arussoItaly/DCF77-arduino-nano/(commit log)

2026-10-26 Update README with resistance specifications for LED
    Added resistance value details for optional components.
2026-10-26 Revise wiring diagram and component details
    Updated the wiring diagram and clarified component descriptions in the README.
2026-10-26 Fix formatting in README for Arduino Nano connection
2026-10-26 Update README with RTC pin connections
    Added RTC wiring details to the README.
2026-10-27 Add ferrite recommendation for Arduino Nano power
    Added recommendation for using a ferrite on the power cable to avoid disturbances when powering the Arduino Nano.
2026-10-28 Revise README with updated circuit diagrams
    Updated schematic diagrams and component descriptions in README.
2026-10-28 Fix pin connection formatting for DS1302
    Updated pin connections for DS1302 in the README.
2026-11-04 Update README with RC8000 antenna orientation details
    Added information about the orientation of the RC8000 antenna for optimal DCF77 signal reception.
